ArnaudOLIVO/RNTA/MOKADDEM-YASSINE-rapport-de-séance-8.docx

Rapport de séance (04/03/2019)

Nous avons tout d'abord commencé par finalisé quelques details dans notre projet qui est presque fini. D'ailleurs nous avons mis en place l'alimentation par les piles sauf que la puissance étant faible par rapport à celle du secteur (12V contre 6V) les roues tournaient difficilement et nous étions contraints de rajouter deux autres piles.

Le projet étant presque fini, j'ai commencé l'écriture du rapport final.
J'ai fait la première page du rapport ainsi que sa mise en page. J'ai pu aussi finir le sommaire, l'introduction. On a aussi commencé la partie déplacement où il nous reste que la partie algorithmique.
