ArnaudOLIVO/RNTA/MOKADDEM-YASSINE-rapport-de-séance-7.docx

Rapport de séance (25/02/2019)

Nous avons d'abord commencé par rajouter d'autres ports pour pouvoir brancher tous les cables en utilisant le fer à souder.
Par la suite pour pouvoir voir si notre programme du moteur pas à pas marche, nous avons réaliser tous les branchements et cela a bien fonctionné.

Après nous sommes partis au Fab Lab. Nous avons d'abord commencé par créer le premier support pour le moteur pas à pas en collant deux triangles l'un sur l'autre.

Ensuite on a procédé à la création de la pièce qui va permettre de coller la crémaillère à la pièce qui va débarasser la poussière.
