ArnaudOLIVO/RNTA/MOKADDEM-YASSINE-rapport-de-séance3.docx

Rapport de séance (10/01/19)

- On a commencé par dessiner les emplacements de nos composants sur notre planche (piles , les 2 moteurs , la roue libre , la puce LS ...)
- Après nous avons commencé à percer pour pouvoir fixer les composants, j'ai commencé par faire un trou au milieu pour faire passer les fils à l'aide de la perceuse et la lime, ensuite j'ai collé les moteurs sauf que j'ai renconté un problème puisque la colle ne tenait pas. Par la suite j'ai fixé la boite à piles et la puce LS. Enfin j'ai procédé à la fixation de la troisième roue sauf que qu'on a rencontré quelques difficultés puisque il fallait qu'elle soit au même niveau que les 2 roues arrières donc on a décidé de créér nos propres entretoise pour pouvoir le réaliser.
