ArnaudOLIVO/RNTA/MOKADDEM-YASSINE-rapport-de-séance2.docx

Rapport de séance (20/12/2018)

- Caracterisation du projet : Nous avons changé d'avis concernant la taille de notre robot (12*18).
- Construction du robot : Nous avons commencé la fabrication du robot. On a découpé la plaque de bois à l'aide de la scie. Par la suite nous avons commencé la mise en place de nos deux moteurs. Nous avons donc soudé les câbles aux moteurs et à l'aide du programme déja fait au cours des séances de TP on a testé les moteurs sauf qu'on a rencontré un problème avec des deux moteurs parceque les câbles étaient mal soudés. On a donc refait cela et ça a marché.
- Nous avons aussi obtenu le module bluetooth.
