ArnaudOLIVO/RNTA/MOKADDEM-YASSINE-rapport-de-séance.rtf

Rapport de séance (13/12/2018)

• Création du Github
• Réalisation du cahier des charges :
Caracterisation du projet :
nom du projet(RNTA), taille du robot(10*15),...
Définition du matériel dont on a besoin :
Choix des moteurs, des roues, des détécteurs,...
On a choisi les mêmes moteurs et les mêmes roues utilisés lors des TPs.
• Finalement nous avons procédé à la division de notre projet en 2 parties pour mieux organiser notre travail.
Déplacement : Dans cette partie nous allons réaliser le montage du robot qui devra se déplacer correctement aisni que la partie algorithmique qui va avec.
Gestion des miettes : Dans cette partie nous allons réaliser le montage de la balayette, des moteurs pas à pas ainsi que la partie algorithmique qui va avec.
