ArnaudOLIVO/RNTA/Doc/Presentation RNTA.pdf

Par : Olivo Arnaud
Et Mokaddem Ahmed Yassine

# RNTA

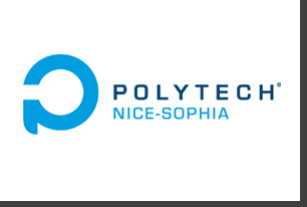
[picture p27: figure]

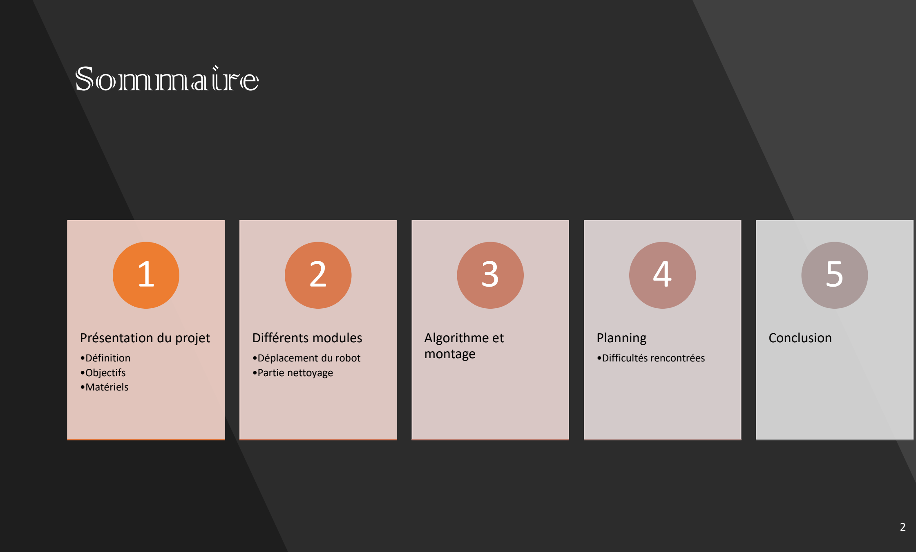
[picture p28: figure]
Sommaire; Présentation du projet; •Définition •Objectifs •Matériels; Différents modules; •Déplacement du robot •Partie nettoyage; Algorithme et montage; Planning; •Difficultés rencontrées; Conclusion

# Présentation du projet

## Définition :

### - Le RNTA c’est quoi ?

## Robot Nettoyeur

de

## Table Arduino

## Objectifs :

Contrôlable par Bluetooth

Nettoyer une table

Capable de rester sur une
table

# Présentation du projet

### - 2 Moteurs CC - L 298-quadruple demi pont en H - Moteur Pas à Pas - Capteur IR

- HC-05

### - Arduino - Alimenté par une pile 9V - Bois

### Matériels :

# Différents modules :

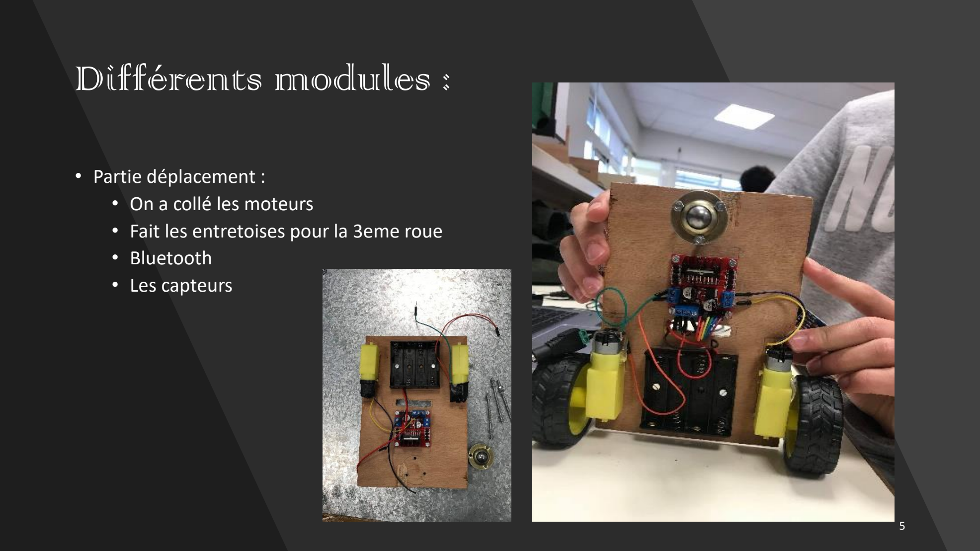
[picture p29: page 5]

- Partie déplacement :
- On a collé les moteurs
- Fait les entretoises pour la 3eme roue
- Bluetooth
- Les capteurs

# Différents modules

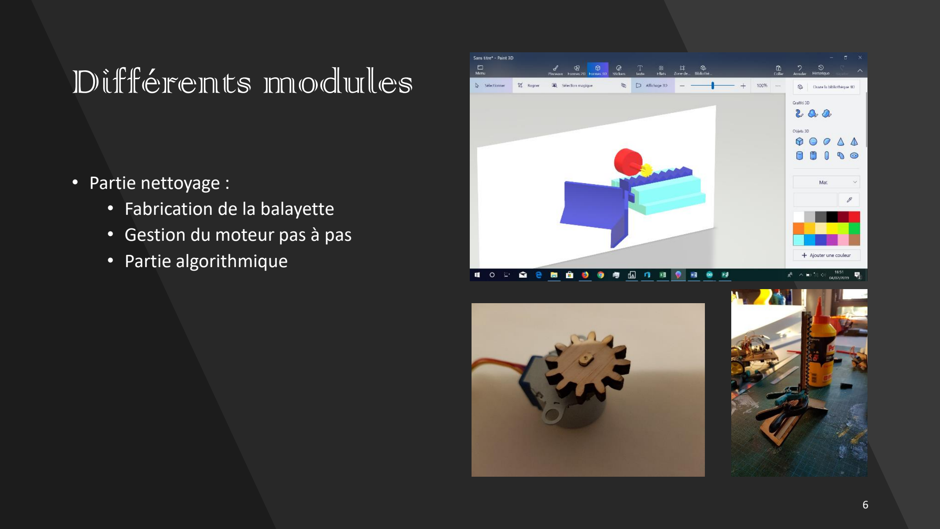
[picture p30: page 6]

- Partie nettoyage :
- Fabrication de la balayette
- Gestion du moteur pas à pas
- Partie algorithmique

# Algorithme et montage

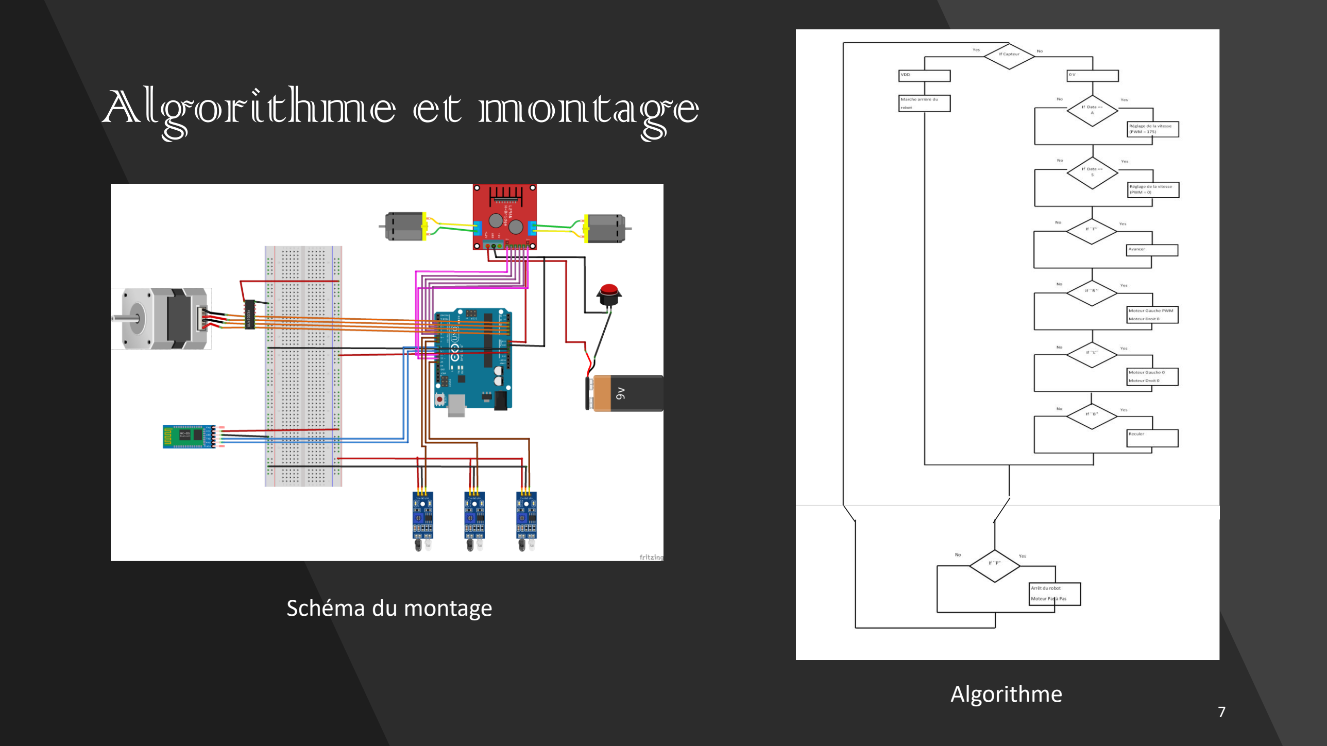
[picture p31: page 7]

Schéma du montage

Algorithme

# Planning

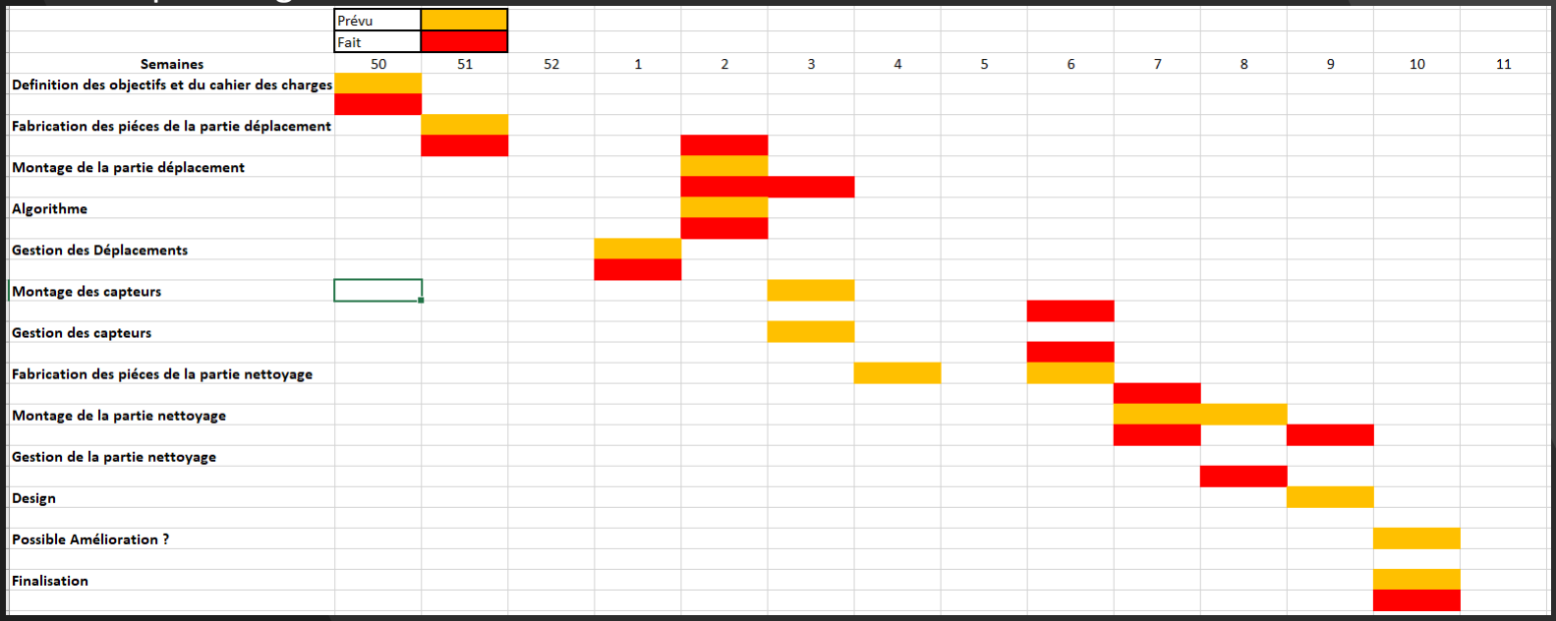
[picture p32: figure]

- Photo du planning

# Difficultés rencontrées

### - Coller les moteurs - Les soudures qui ne tenaient pas - La fixation de la roue arrière - Les supports des capteurs - Les piles

# Conclusion

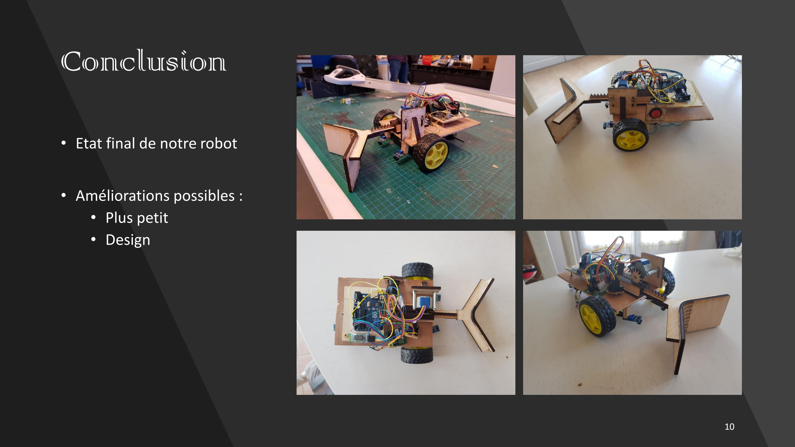
[picture p33: page 10]

- Etat final de notre robot
- Améliorations possibles :
- Plus petit
- Design
