ArnaudOLIVO/RNTA/Support.dxf

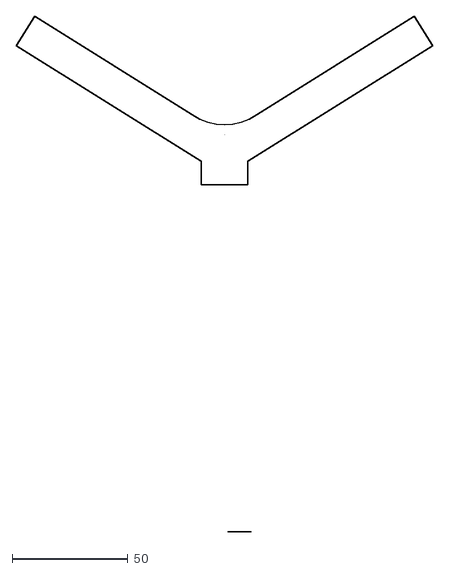
[picture p34: CAD file, 2019-03-18]
Support.dxf
180.0 x 222.7
