ArnaudOLIVO/RNTA/poussoir.dxf

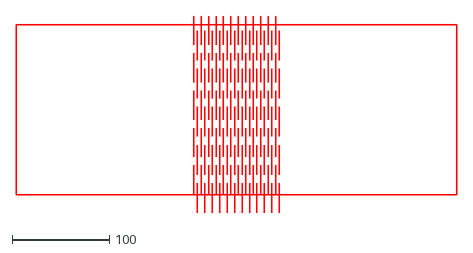
[picture p35: CAD file, 2019-03-18]
poussoir.dxf
452.3 x 201.9
