ArnaudOLIVO/RNTA/Programme/Connection_Bluetooth.ino

#include<SoftwareSerial.h>
#define RX 8
#define TX 9
SoftwareSerial BlueT(RX,TX);
const int LED=3;
void setup() {
  // put your setup code here, to run once:
  Serial.begin(9600);
  delay(500);
  Serial.println("Bonjour -Pret pour les commandes AT");
  BlueT.begin(9600);
  pinMode(LED,OUTPUT);
  digitalWrite(LED, LOW);
  delay(500);
  digitalWrite(LED, HIGH);

}

void loop() {
  // put your main code here, to run repeatedly:
  while (BlueT.available()) {
  Serial.print(char(BlueT.read()));}
  while (Serial.available()) {
  BlueT.write(char(Serial.read()));}
}
